victorsvi/SonicMatrix/cover.png

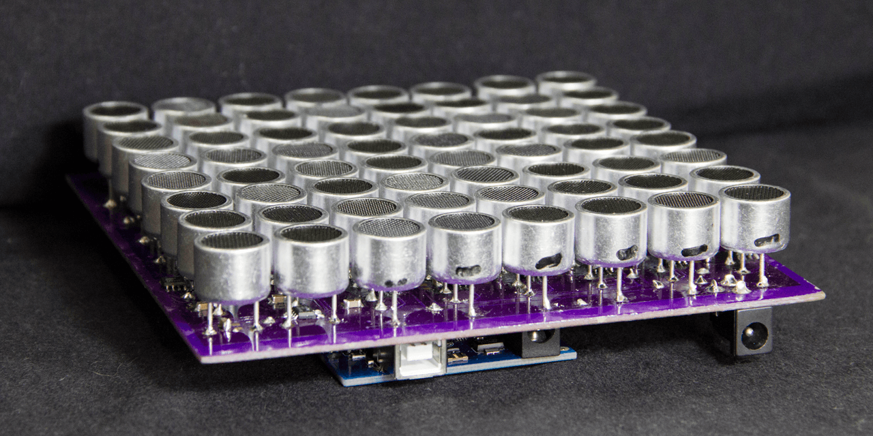
cover.png
