victorsvi/SonicMatrix/hw/doc/Requirements.md

# HARDWARE REQUIREMENTS

- Custom board with 64 transducers controlled by 64 power mosfets in independent channels.
- Must have pin headers aligned to the arduino mega headers.
- Input 12-18VDC.
- Simple series diode reverse polarity protection.
- Have a voltage regulator with 9v output to power the arduino via Vin. There must be a jumper to connect ou disconnect the power to the arduino.
- The board must accomodate the 64 transducers in a 8 x 8 matrix.
