victorsvi/SonicMatrix/sw/doc/Error Codes.md

# ERROR CODES

### GENERIC

|Code|Description|
|---|---|
|1|Memory allocation error|
|2|Unable to open file |
|3|Null pointer |
|4|Index out of bounds |

### ULTRASONIC

|Code|Description|
|---|---|
|40|The transducer array pointer is null |
|41|Invalid size for the transducer array|
|42|Invalid value for transducer diameter|
|43|Invalid value for phase resolution |
|44|The transducer pointer is null |
