victorsvi/SonicMatrix/hw/doc/Datasheets/TCT40 size.jpg

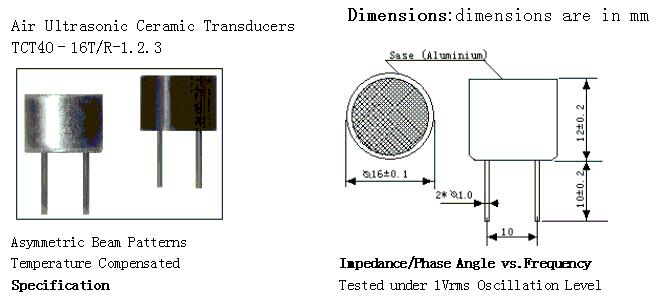
hw/doc/Datasheets/TCT40 size.jpg
