victorsvi/SonicMatrix/hw/doc/Datasheets/TCT40 specs.jpg

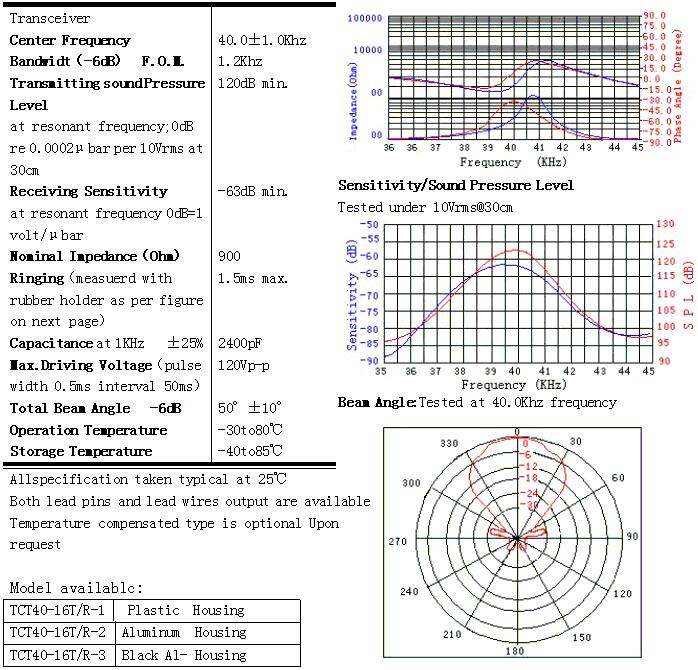
hw/doc/Datasheets/TCT40 specs.jpg
