victorsvi/SonicMatrix/hw/doc/BOM.md

# TRANSDUCER ARRAY BOARD
### Bill of Materials

|Quatity|Part Number|Description|
|---|---|---|
|1|AtMega 2560|Arduino Mega board|
|64|TCT-40-16T|16mm diameter 40kHz ultrasonic transmitter|
|32|TC4427|dual channel power mosfet SOIC|
|1|1n4001|rectifier diode trough hole|
|1|78L09|9V linear regulator TO-92|
|64|-|2.2 uF ceramic capacitor 1206 SMD|
|1|-|tactile switch 5x5 4 pins|
|2|-|100pF ceramic capacitor trough hole|
|1|-|header pin jumper|
|3|-|40x1 male pin header 2.54mm|
|1|-|P4 female DC jack 2,1mm|
