victorsvi/SonicMatrix/hw/board/print/b_mask.pdf

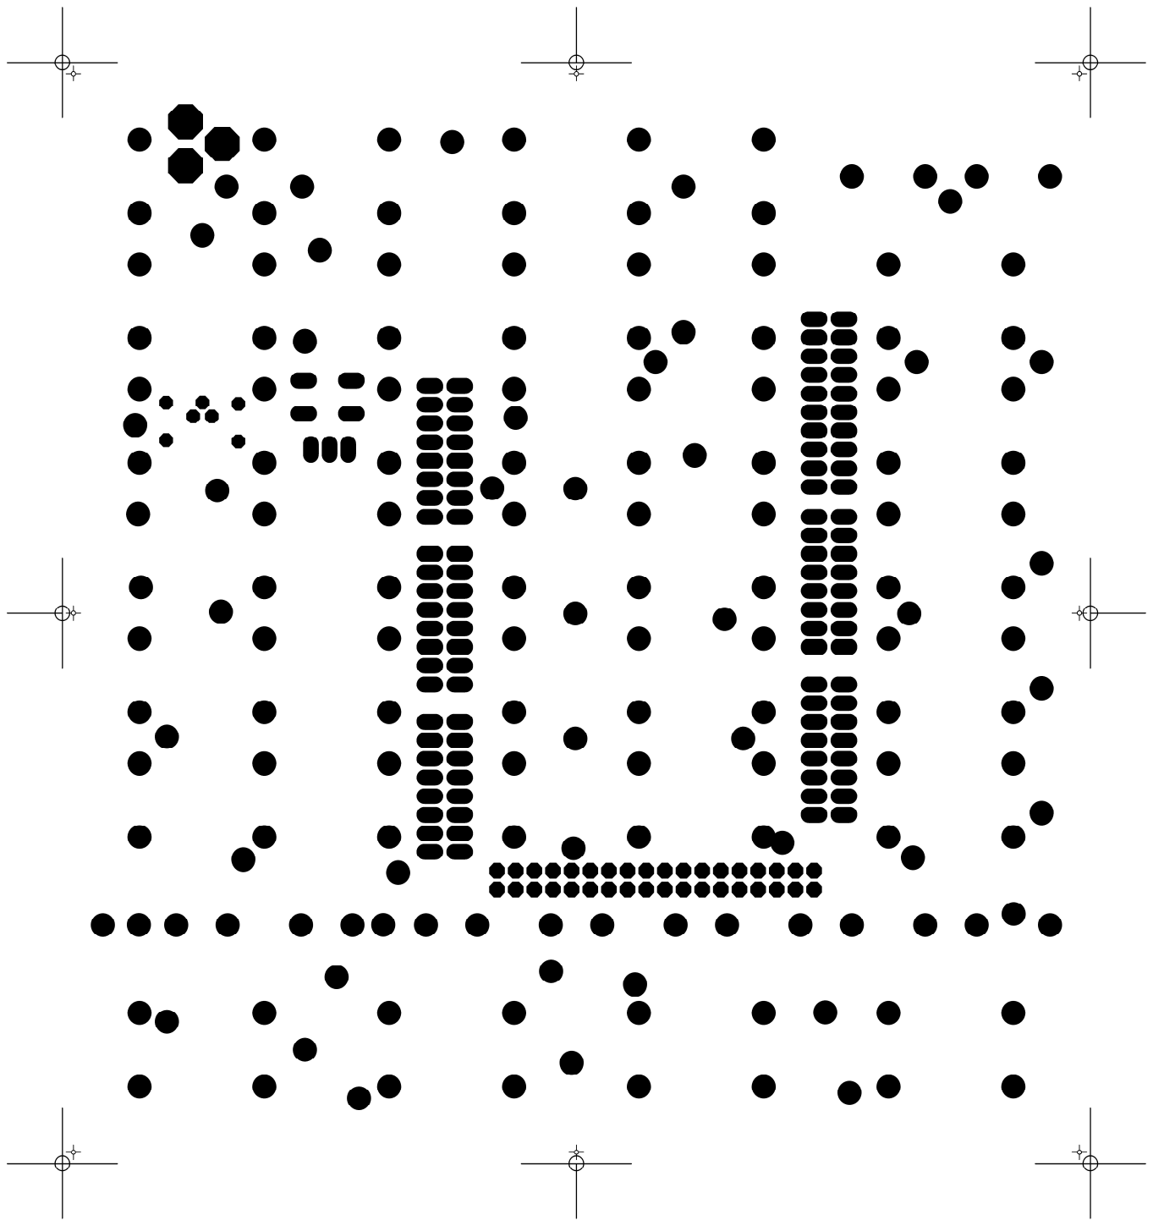
[picture p12: page 1]
