victorsvi/SonicMatrix/hw/board/print/t_mask.pdf

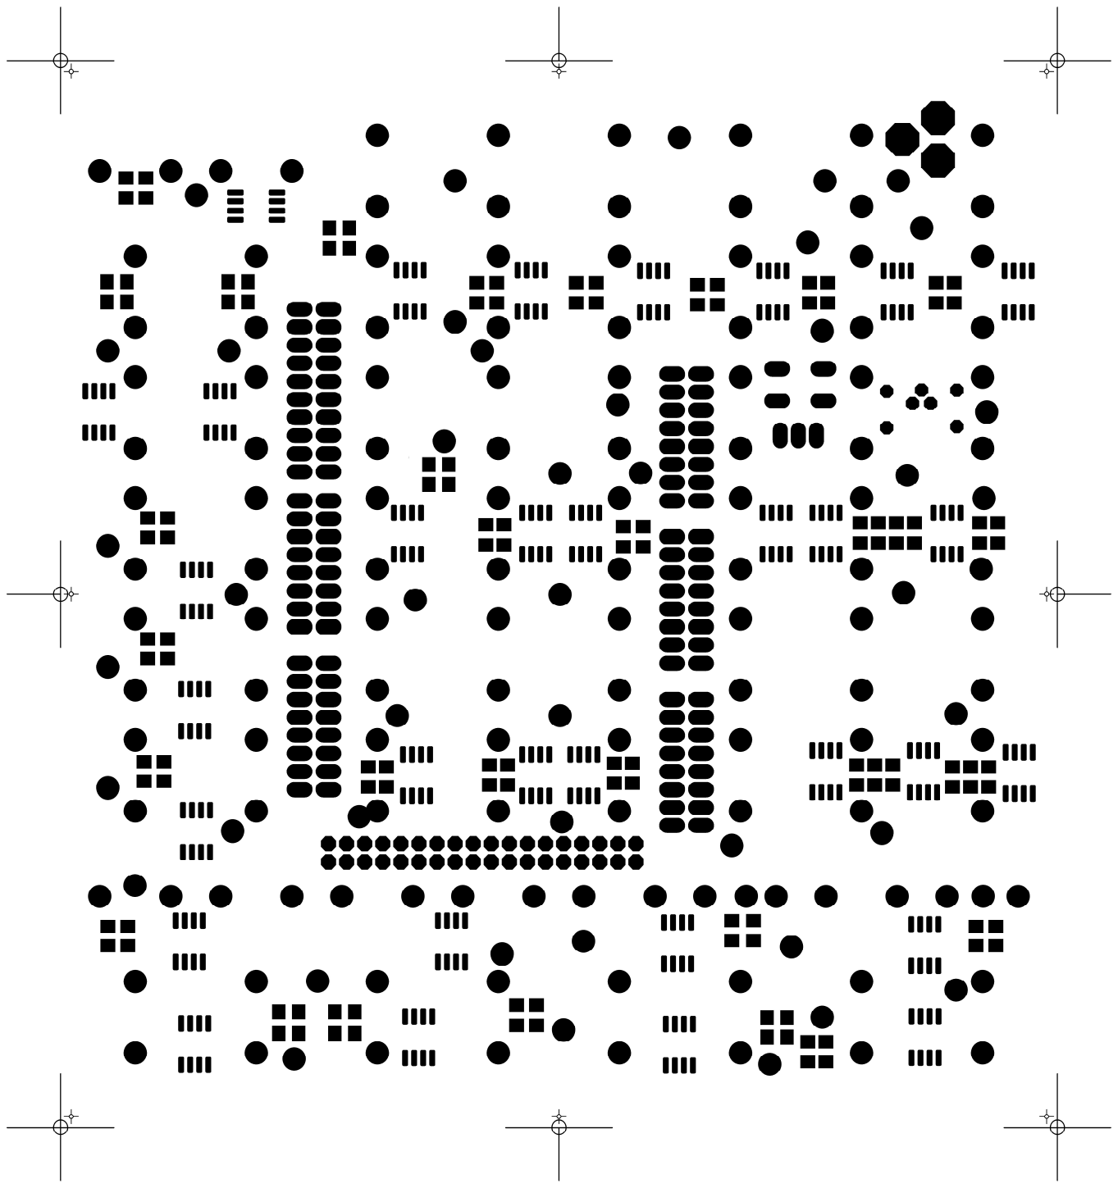
[picture p13: page 1]
