victorsvi/SonicMatrix/hw/board/print/b_etch.png

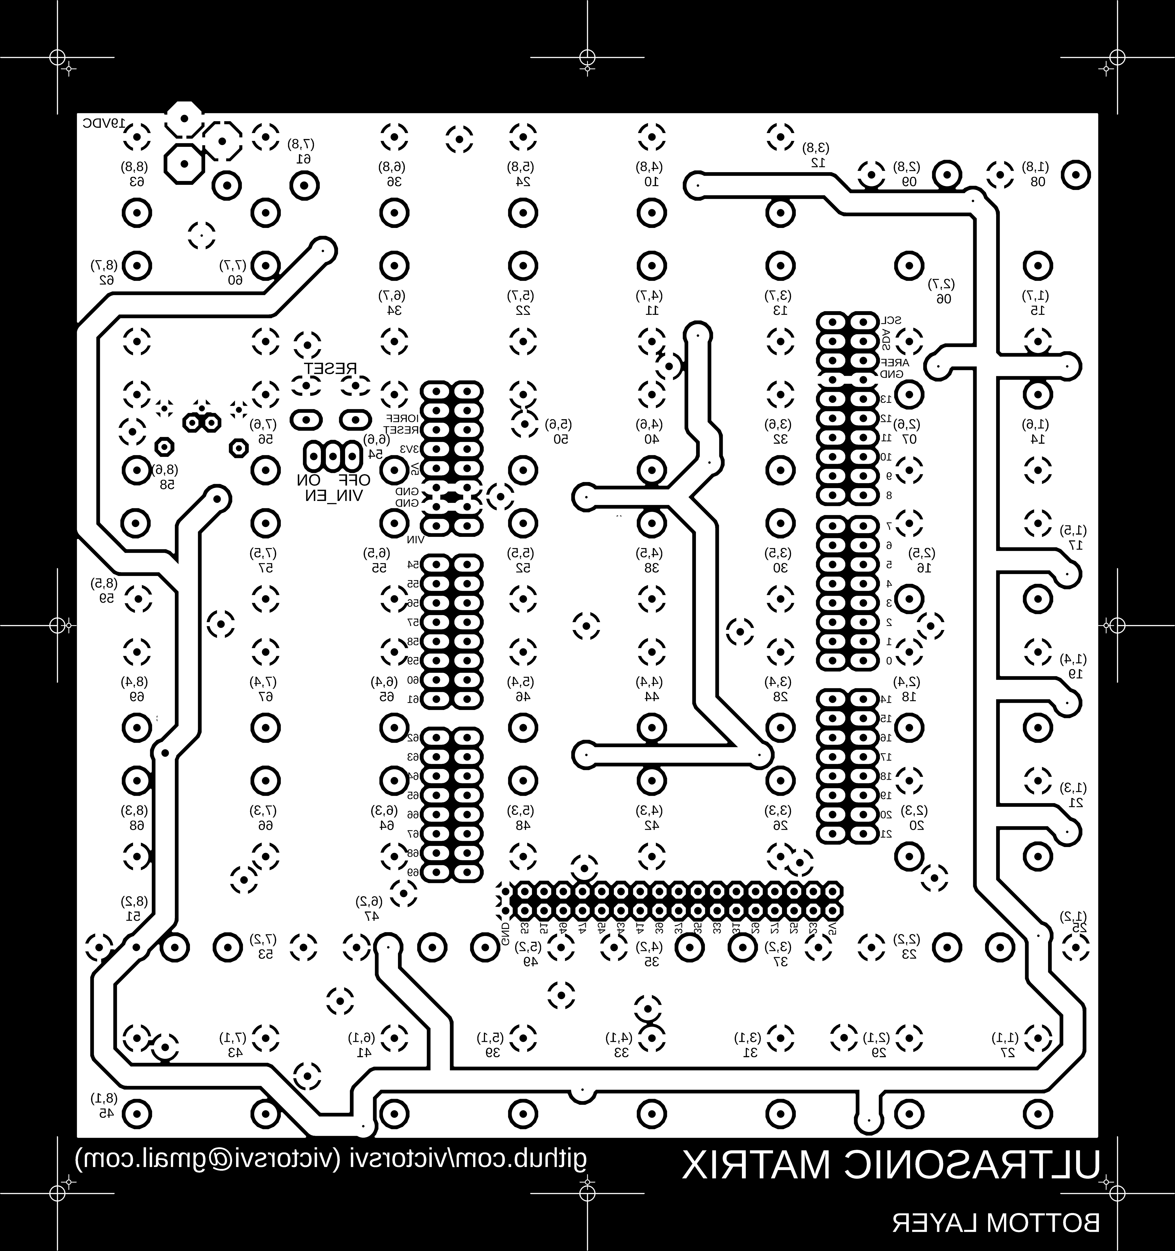
hw/board/print/b_etch.png
