victorsvi/SonicMatrix/hw/board/print/b_mask.png

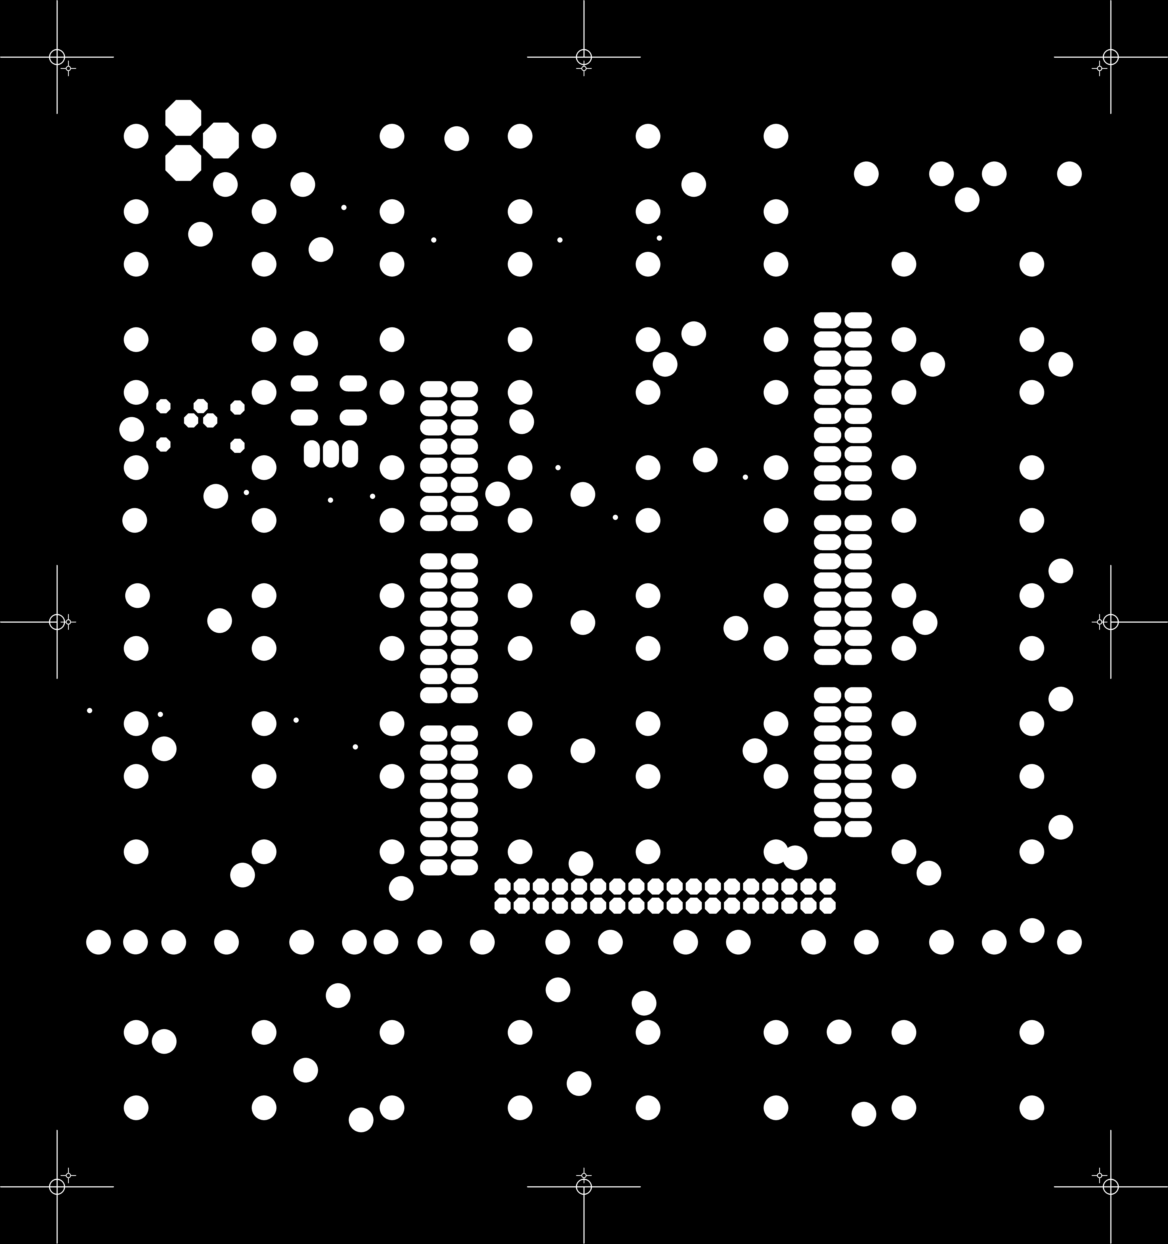
hw/board/print/b_mask.png
