victorsvi/SonicMatrix/hw/board/print/grid2.png

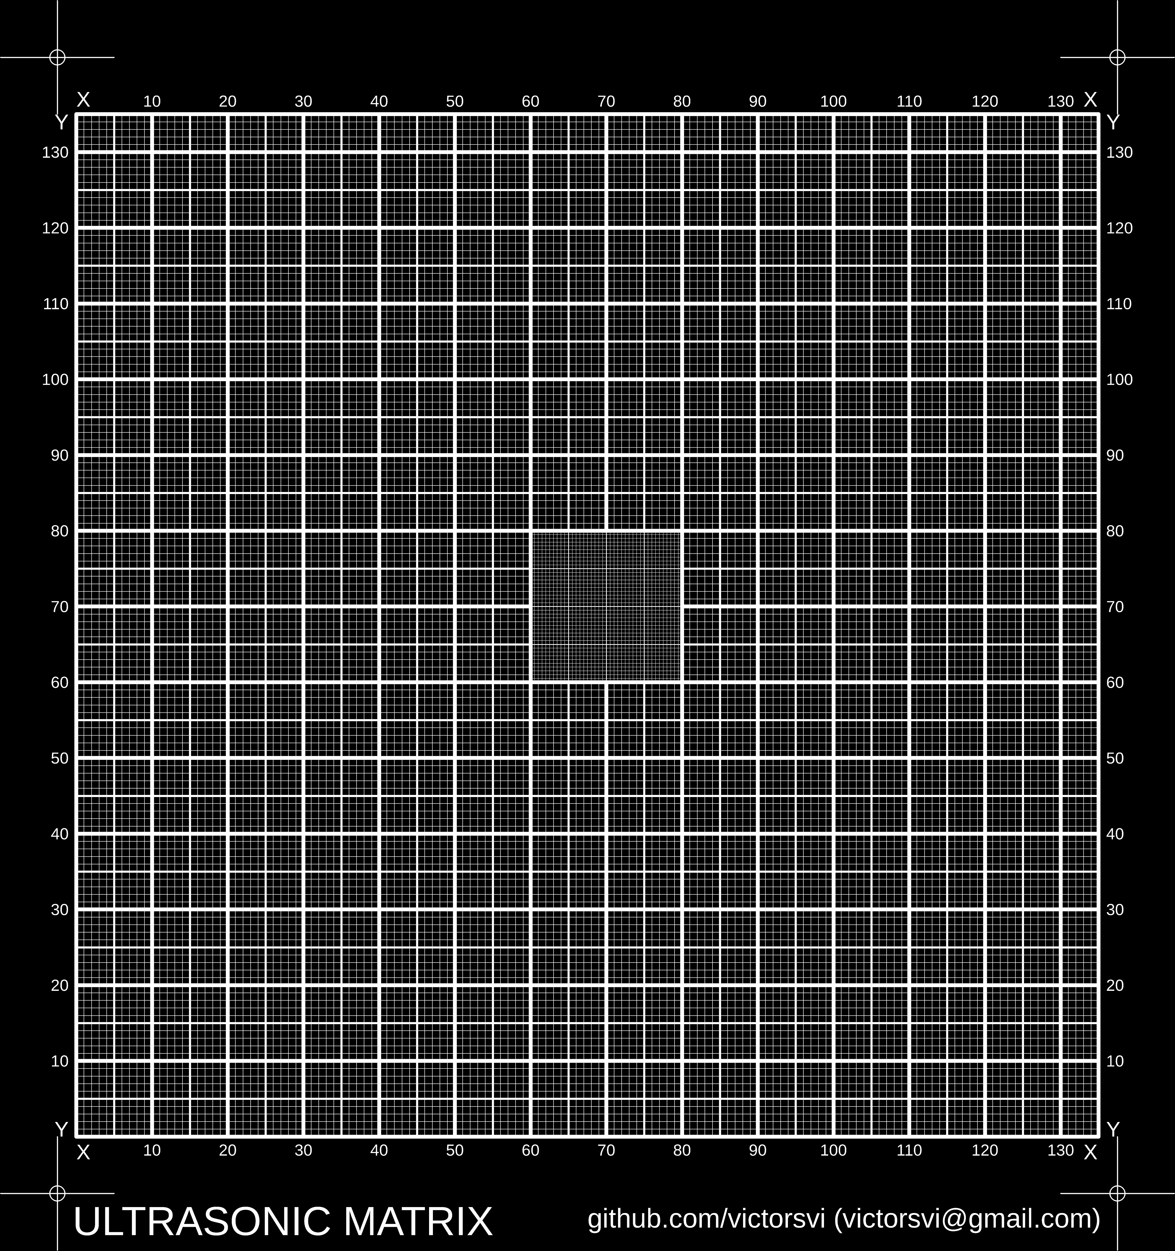
hw/board/print/grid2.png
