victorsvi/SonicMatrix/hw/board/print/place.png

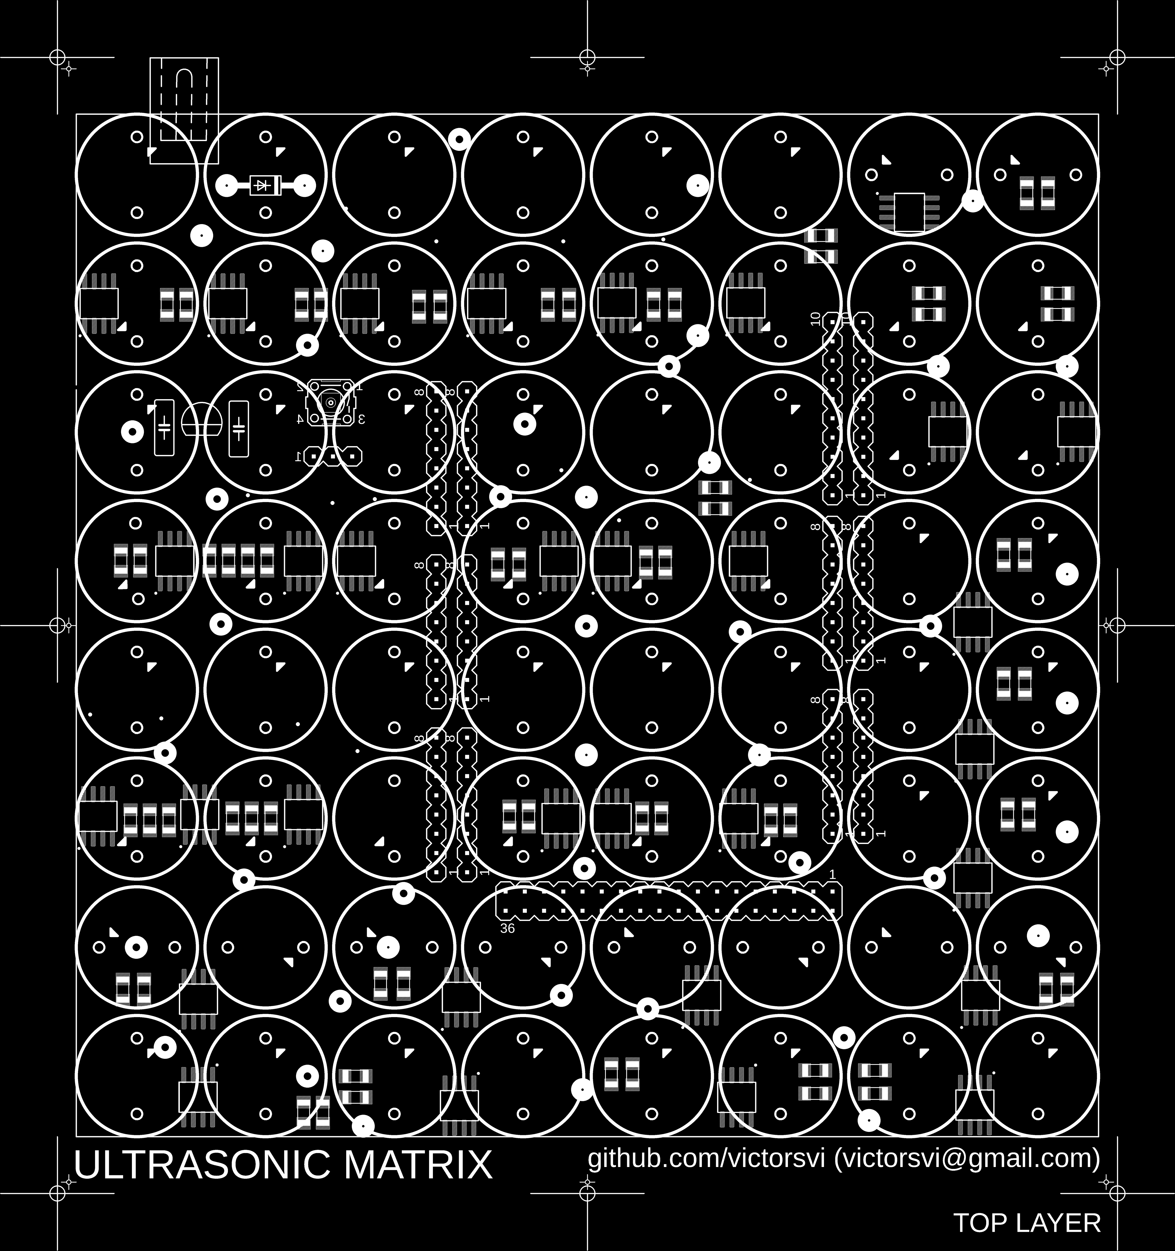
hw/board/print/place.png
