victorsvi/SonicMatrix/hw/board/print/t_etch.png

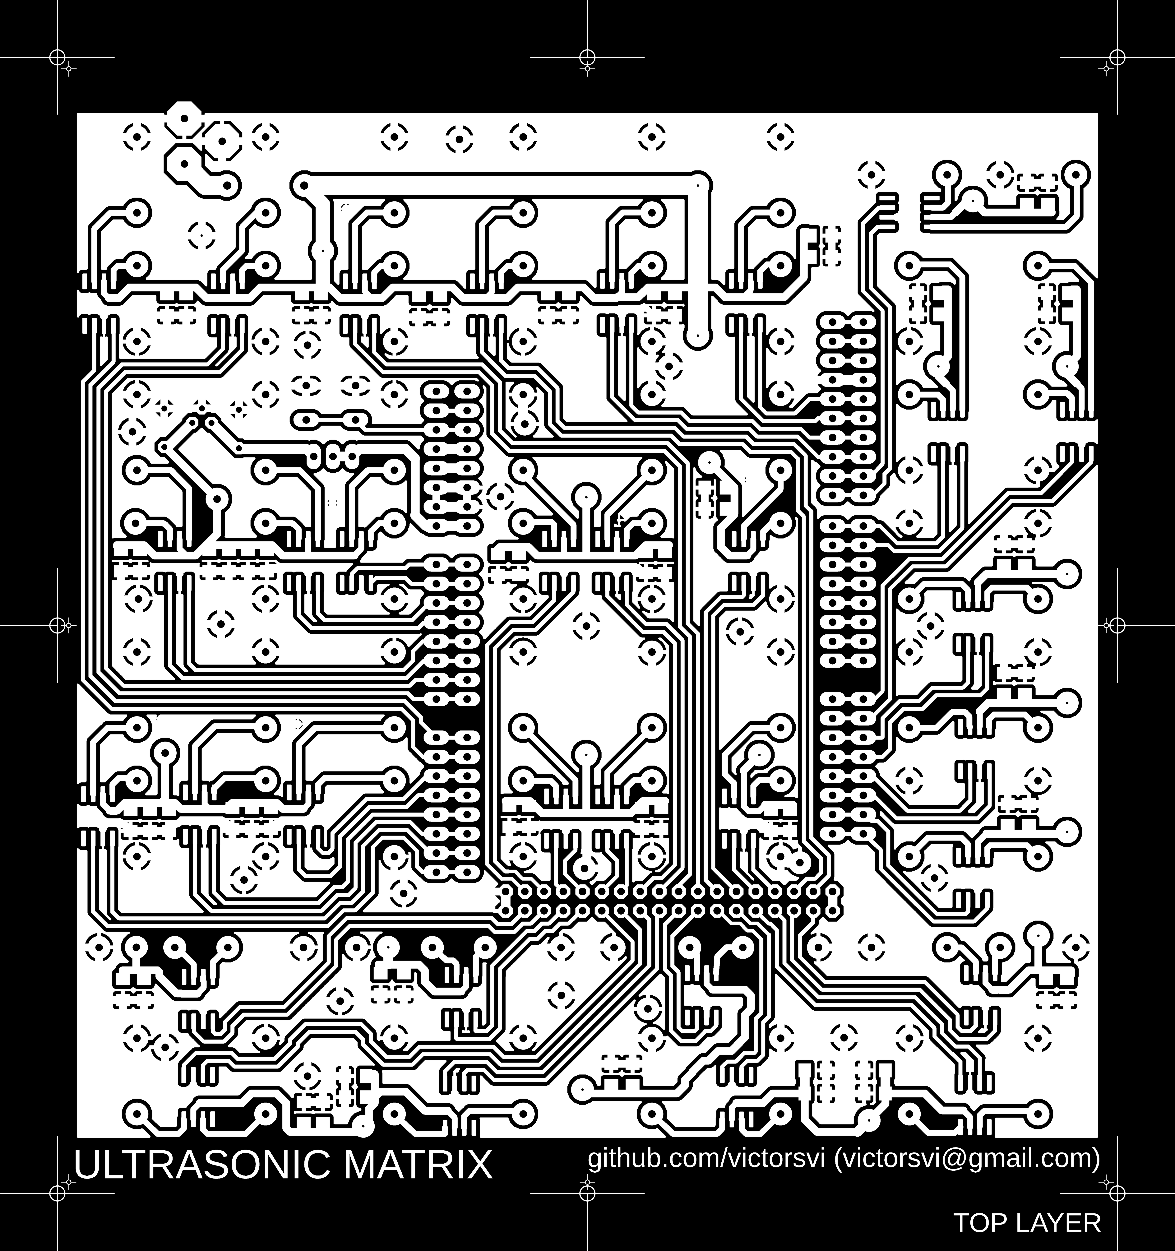
hw/board/print/t_etch.png
