victorsvi/SonicMatrix/hw/board/print/t_mask.png

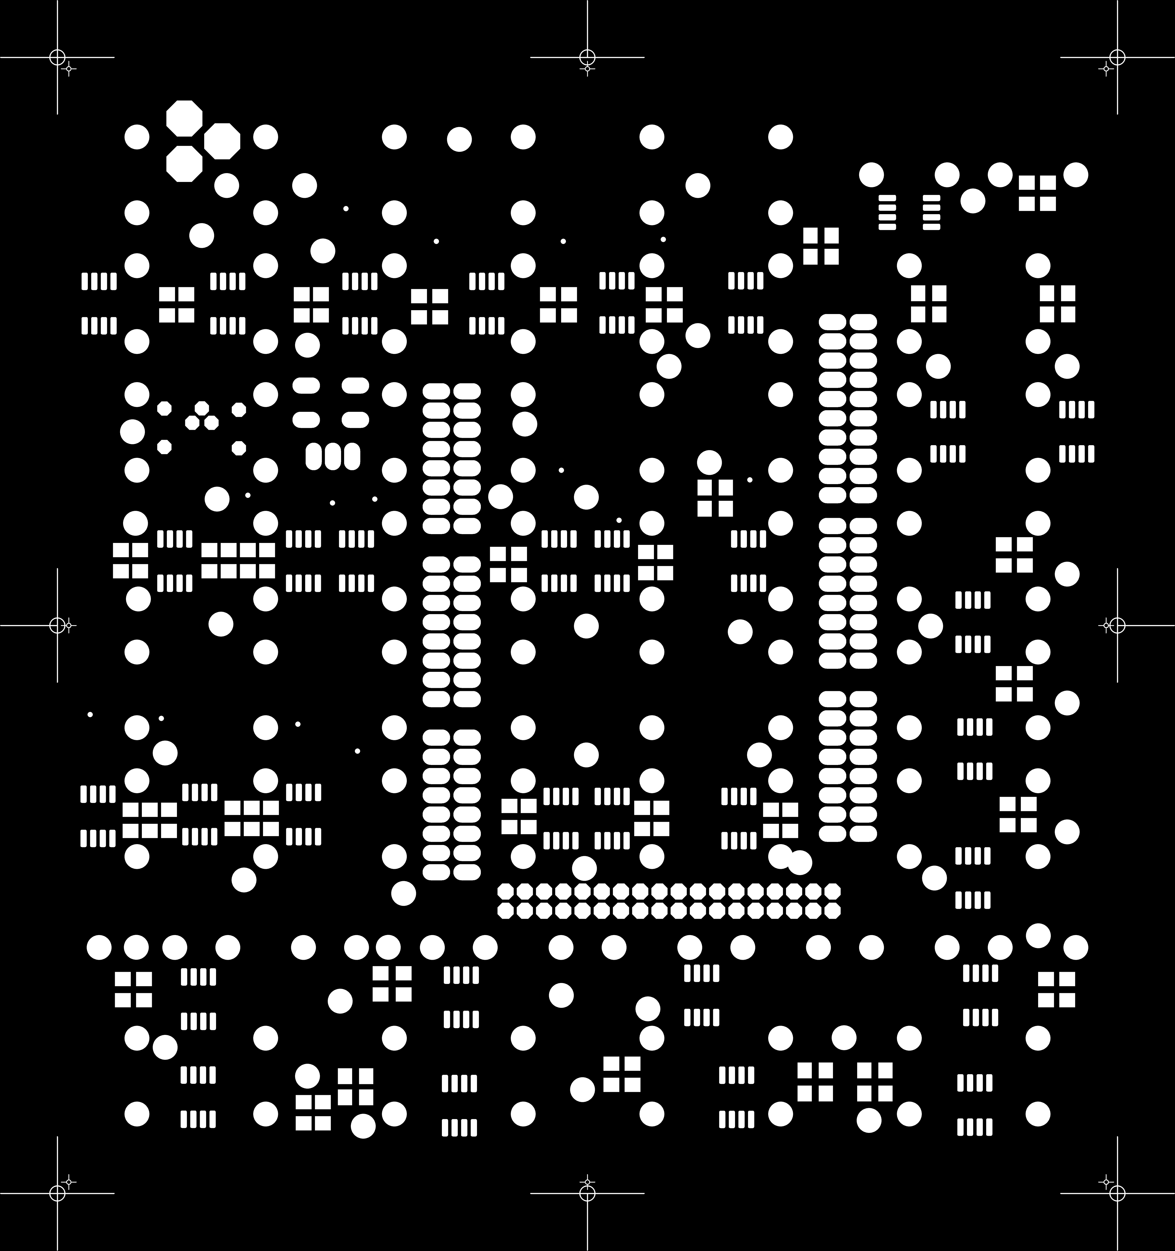
hw/board/print/t_mask.png
