victorsvi/SonicMatrix/sw/doc/Pin Mapping and Calibration.xlsx

BANK | BIT | PIN_NUM | PIN_DESC | USED | ARRAY_X | ARRAY_Y | PH_MEASURE | PH_SUPLEMENT | PH_OFFSET | PH_COMP
PA | 5 | 27 | D27 | TRUE | 1 | 1 | 150 | 210 | 35 | 25 | 27, 25, //x1 y1
PA | 3 | 25 | D25 | TRUE | 1 | 2 | 162 | 198 | 23 | 16 | 25, 16, //x1 y2
PD | 0 | 21 | I2C_SCL | TRUE | 1 | 3 | 139 | 221 | 46 | 33 | 21, 33, //x1 y3
PD | 2 | 19 | USART1_RX | TRUE | 1 | 4 | 121 | 239 | 64 | 45 | 19, 45, //x1 y4
PH | 0 | 17 | USART2_RX | TRUE | 1 | 5 | 150 | 210 | 35 | 25 | 17, 25, //x1 y5
PJ | 1 | 14 | USART3_TX | TRUE | 1 | 6 | 121 | 239 | 64 | 45 | 14, 45, //x1 y6
PJ | 0 | 15 | USART3_RX | TRUE | 1 | 7 | 110 | 250 | 75 | 53 | 15, 53, //x1 y7
PH | 5 | 8 | PWM8 | TRUE | 1 | 8 | 145 | 215 | 40 | 28 | 8, 28, //x1 y8
PA | 7 | 29 | D29 | TRUE | 2 | 1 | 139 | 221 | 46 | 33 | 29, 33, //x2 y1
PA | 1 | 23 | D23 | TRUE | 2 | 2 | 46 | 314 | 139 | 98 | 23, 98, //x2 y2 | invertido? | 133
PD | 1 | 20 | I2C_SDA | TRUE | 2 | 3 | 124 | 236 | 61 | 43 | 20, 43, //x2 y3
PD | 3 | 18 | USART1_TX | TRUE | 2 | 4 | 104 | 256 | 81 | 57 | 18, 57, //x2 y4
PH | 1 | 16 | USART2_TX | TRUE | 2 | 5 | 145 | 215 | 40 | 28 | 16, 28, //x2 y5
PH | 4 | 7 | PWM7 | TRUE | 2 | 6 | 98 | 262 | 87 | 62 | 7, 62, //x2 y6
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
