victorsvi/SonicMatrix/hw/board/UltrasonicMatrix.brd

## EAGLE design hw/board/UltrasonicMatrix.brd (2020-06-22)

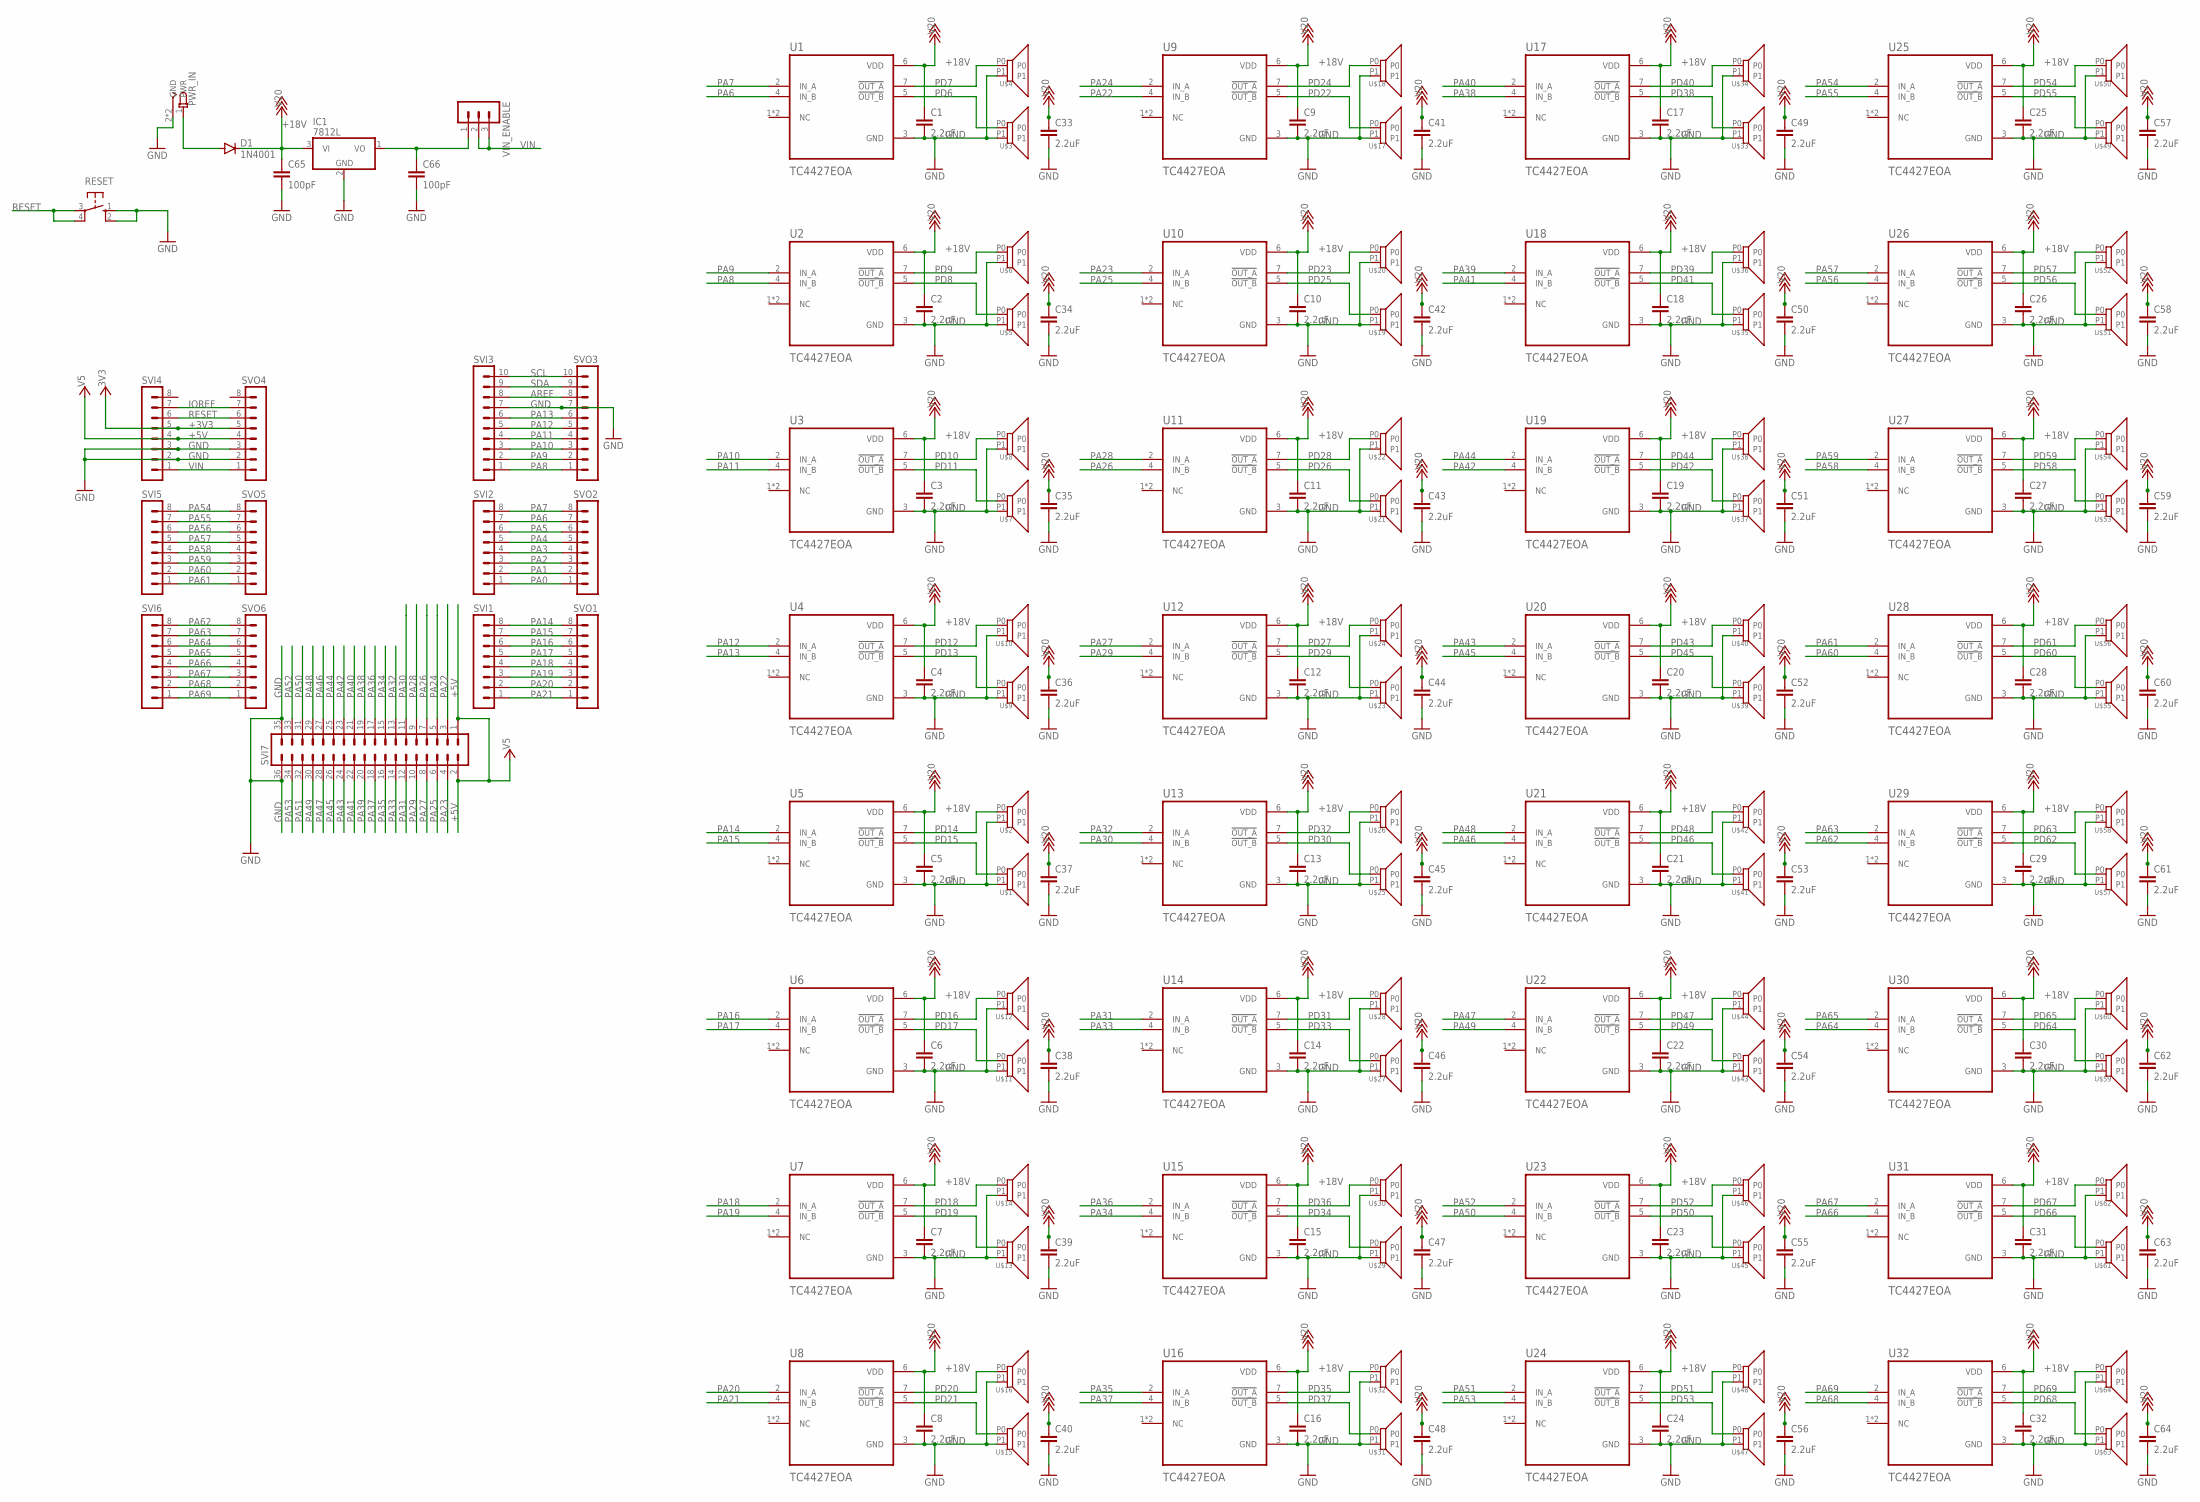
[picture p20: schematic UltrasonicMatrix.sch]

Parts:
C1, C2, C3, C4, C5, C6, C7, C8, C9, C10, C11, C12, C13, C14, C15, C16, C17, C18, C19, C20, C21, C22, C23, C24, C25, C26, C27, C28, C29, C30, C31, C32, C33, C34, C35, C36, C37, C38, C39, C40, C41, C42, C43, C44, C45, C46, C47, C48, C49, C50, C51, C52, C53, C54, C55, C56, C57, C58, C59, C60, C61, C62, C63, C64: 2.2uF; C1206
C65, C66: 100pF; C050-025X075
D1: 1N4001; DO41-10
IC1: 7812L; TO92
PWR_IN: DCJACK
RESET: 10-XX; B3F-10XX
SVI1, SVI2, SVI4, SVI5, SVI6: MA08-1
SVI3: MA10-1
SVI7: MA18-2
SVO1, SVO2, SVO4, SVO5, SVO6: MA08-1
SVO3: MA10-1
U1, U2, U3, U4, U5, U6, U7, U8, U9, U10, U11, U12, U13, U14, U15, U16, U17, U18, U19, U20, U21, U22, U23, U24, U25, U26, U27, U28, U29, U30, U31, U32: TC4427EOA; SOIC127P599X175-8N
U$1, U$2, U$3, U$4, U$5, U$6, U$7, U$8, U$9, U$10, U$11, U$12, U$13, U$14, U$15, U$16, U$17, U$18, U$19, U$20, U$21, U$22, U$23, U$24, U$25, U$26, U$27, U$28, U$29, U$30, U$31, U$32, U$33, U$34, U$35, U$36, U$37, U$38, U$39, U$40, U$41, U$42, U$43, U$44, U$45, U$46, U$47, U$48, U$49, U$50, U$51, U$52, U$53, U$54, U$55, U$56, U$57, U$58, U$59, U$60, U$61, U$62, U$63, U$64: TCT40-16
VIN_ENABLE: MA03-1

Connections:
+3V3: SVI4.5, SVO4.5
+5V: SVI4.4, SVI7.1, SVI7.2, SVO4.4
+18V: C1.1, C2.1, C3.1, C4.1, C5.1, C6.1, C7.1, C8.1, C9.1, C10.1, C11.1, C12.1, C13.1, C14.1, C15.1, C16.1, C17.1, C18.1, C19.1, C20.1, C21.1, C22.1, C23.1, C24.1, C25.1, C26.1, C27.1, C28.1, C29.1, C30.1, C31.1, C32.1, C33.1, C34.1, C35.1, C36.1, C37.1, C38.1, C39.1, C40.1, C41.1, C42.1, C43.1, C44.1, C45.1, C46.1, C47.1, C48.1, C49.1, C50.1, C51.1, C52.1, C53.1, C54.1, C55.1, C56.1, C57.1, C58.1, C59.1, C60.1, C61.1, C62.1, C63.1, C64.1, C65.1, D1.C, IC1.3 (VI), U1.6 (VDD), U2.6 (VDD), U3.6 (VDD), U4.6 (VDD), U5.6 (VDD), U6.6 (VDD), U7.6 (VDD), U8.6 (VDD), U9.6 (VDD), U10.6 (VDD), U11.6 (VDD), U12.6 (VDD), U13.6 (VDD), U14.6 (VDD), U15.6 (VDD), U16.6 (VDD), U17.6 (VDD), U18.6 (VDD), U19.6 (VDD), U20.6 (VDD), U21.6 (VDD), U22.6 (VDD), U23.6 (VDD), U24.6 (VDD), U25.6 (VDD), U26.6 (VDD), U27.6 (VDD), U28.6 (VDD), U29.6 (VDD), U30.6 (VDD), U31.6 (VDD), U32.6 (VDD)
AREF: SVI3.8, SVO3.8
GND: C1.2, C2.2, C3.2, C4.2, C5.2, C6.2, C7.2, C8.2, C9.2, C10.2, C11.2, C12.2, C13.2, C14.2, C15.2, C16.2, C17.2, C18.2, C19.2, C20.2, C21.2, C22.2, C23.2, C24.2, C25.2, C26.2, C27.2, C28.2, C29.2, C30.2, C31.2, C32.2, C33.2, C34.2, C35.2, C36.2, C37.2, C38.2, C39.2, C40.2, C41.2, C42.2, C43.2, C44.2, C45.2, C46.2, C47.2, C48.2, C49.2, C50.2, C51.2, C52.2, C53.2, C54.2, C55.2, C56.2, C57.2, C58.2, C59.2, C60.2, C61.2, C62.2, C63.2, C64.2, C65.2, C66.2, IC1.2 (GND), PWR_IN.2 (GND), PWR_IN.3 (GND), RESET.1 (S), RESET.2 (S1), SVI3.7, SVI4.2, SVI4.3, SVI7.35, SVI7.36, SVO3.7, SVO4.2, SVO4.3, U1.3 (GND), U2.3 (GND), U3.3 (GND), U4.3 (GND), U5.3 (GND), U6.3 (GND), U7.3 (GND), U8.3 (GND), U9.3 (GND), U10.3 (GND), U11.3 (GND), U12.3 (GND), U13.3 (GND), U14.3 (GND), U15.3 (GND), U16.3 (GND), U17.3 (GND), U18.3 (GND), U19.3 (GND), U20.3 (GND), U21.3 (GND), U22.3 (GND), U23.3 (GND), U24.3 (GND), U25.3 (GND), U26.3 (GND), U27.3 (GND), U28.3 (GND), U29.3 (GND), U30.3 (GND), U31.3 (GND), U32.3 (GND), U$1.P1, U$2.P1, U$3.P1, U$4.P1, U$5.P1, U$6.P1, U$7.P1, U$8.P1, U$9.P1, U$10.P1, U$11.P1, U$12.P1, U$13.P1, U$14.P1, U$15.P1, U$16.P1, U$17.P1, U$18.P1, U$19.P1, U$20.P1, U$21.P1, U$22.P1, U$23.P1, U$24.P1, U$25.P1, U$26.P1, U$27.P1, U$28.P1, U$29.P1, U$30.P1, U$31.P1, U$32.P1, U$33.P1, U$34.P1, U$35.P1, U$36.P1, U$37.P1, U$38.P1, U$39.P1, U$40.P1, U$41.P1, U$42.P1, U$43.P1, U$44.P1, U$45.P1, U$46.P1, U$47.P1, U$48.P1, U$49.P1, U$50.P1, U$51.P1, U$52.P1, U$53.P1, U$54.P1, U$55.P1, U$56.P1, U$57.P1, U$58.P1, U$59.P1, U$60.P1, U$61.P1, U$62.P1, U$63.P1, U$64.P1
IOREF: SVI4.7, SVO4.7
unnamed: D1.A, PWR_IN.1 (PWR)
unnamed: C66.1, IC1.1 (VO), VIN_ENABLE.1
PA0: SVI2.1, SVO2.1
PA1: SVI2.2, SVO2.2
PA2: SVI2.3, SVO2.3
PA3: SVI2.4, SVO2.4
PA4: SVI2.5, SVO2.5
PA5: SVI2.6, SVO2.6
PA6: SVI2.7, SVO2.7, U1.4 (IN_B)
PA7: SVI2.8, SVO2.8, U1.2 (IN_A)
PA8: SVI3.1, SVO3.1, U2.4 (IN_B)
PA9: SVI3.2, SVO3.2, U2.2 (IN_A)
PA10: SVI3.3, SVO3.3, U3.2 (IN_A)
PA11: SVI3.4, SVO3.4, U3.4 (IN_B)
PA12: SVI3.5, SVO3.5, U4.2 (IN_A)
PA13: SVI3.6, SVO3.6, U4.4 (IN_B)
PA14: SVI1.8, SVO1.8, U5.2 (IN_A)
PA15: SVI1.7, SVO1.7, U5.4 (IN_B)
PA16: SVI1.6, SVO1.6, U6.2 (IN_A)
PA17: SVI1.5, SVO1.5, U6.4 (IN_B)
PA18: SVI1.4, SVO1.4, U7.2 (IN_A)
PA19: SVI1.3, SVO1.3, U7.4 (IN_B)
PA20: SVI1.2, SVO1.2, U8.2 (IN_A)
PA21: SVI1.1, SVO1.1, U8.4 (IN_B)
PA22: SVI7.3, U9.4 (IN_B)
PA23: SVI7.4, U10.2 (IN_A)
PA24: SVI7.5, U9.2 (IN_A)
PA25: SVI7.6, U10.4 (IN_B)
PA26: SVI7.7, U11.4 (IN_B)
PA27: SVI7.8, U12.2 (IN_A)
PA28: SVI7.9, U11.2 (IN_A)
PA29: SVI7.10, U12.4 (IN_B)
PA30: SVI7.11, U13.4 (IN_B)
PA31: SVI7.12, U14.2 (IN_A)
PA32: SVI7.13, U13.2 (IN_A)
PA33: SVI7.14, U14.4 (IN_B)
PA34: SVI7.15, U15.4 (IN_B)
PA35: SVI7.16, U16.2 (IN_A)
PA36: SVI7.17, U15.2 (IN_A)
PA37: SVI7.18, U16.4 (IN_B)
PA38: SVI7.19, U17.4 (IN_B)
PA39: SVI7.20, U18.2 (IN_A)
PA40: SVI7.21, U17.2 (IN_A)
PA41: SVI7.22, U18.4 (IN_B)
PA42: SVI7.23, U19.4 (IN_B)
PA43: SVI7.24, U20.2 (IN_A)
PA44: SVI7.25, U19.2 (IN_A)
PA45: SVI7.26, U20.4 (IN_B)
PA46: SVI7.27, U21.4 (IN_B)
PA47: SVI7.28, U22.2 (IN_A)
PA48: SVI7.29, U21.2 (IN_A)
PA49: SVI7.30, U22.4 (IN_B)
PA50: SVI7.31, U23.4 (IN_B)
PA51: SVI7.32, U24.2 (IN_A)
PA52: SVI7.33, U23.2 (IN_A)
PA53: SVI7.34, U24.4 (IN_B)
PA54: SVI5.8, SVO5.8, U25.2 (IN_A)
PA55: SVI5.7, SVO5.7, U25.4 (IN_B)
PA56: SVI5.6, SVO5.6, U26.4 (IN_B)
PA57: SVI5.5, SVO5.5, U26.2 (IN_A)
PA58: SVI5.4, SVO5.4, U27.4 (IN_B)
PA59: SVI5.3, SVO5.3, U27.2 (IN_A)
PA60: SVI5.2, SVO5.2, U28.4 (IN_B)
PA61: SVI5.1, SVO5.1, U28.2 (IN_A)
PA62: SVI6.8, SVO6.8, U29.4 (IN_B)
PA63: SVI6.7, SVO6.7, U29.2 (IN_A)
PA64: SVI6.6, SVO6.6, U30.4 (IN_B)
PA65: SVI6.5, SVO6.5, U30.2 (IN_A)
PA66: SVI6.4, SVO6.4, U31.4 (IN_B)
PA67: SVI6.3, SVO6.3, U31.2 (IN_A)
PA68: SVI6.2, SVO6.2, U32.4 (IN_B)
PA69: SVI6.1, SVO6.1, U32.2 (IN_A)
PD6: U1.5 (!OUT_B), U$3.P0
PD7: U1.7 (!OUT_A), U$4.P0
PD8: U2.5 (!OUT_B), U$5.P0
PD9: U2.7 (!OUT_A), U$6.P0
PD10: U3.7 (!OUT_A), U$8.P0
PD11: U3.5 (!OUT_B), U$7.P0
PD12: U4.7 (!OUT_A), U$10.P0
PD13: U4.5 (!OUT_B), U$9.P0
PD14: U5.7 (!OUT_A), U$2.P0
PD15: U5.5 (!OUT_B), U$1.P0
PD16: U6.7 (!OUT_A), U$12.P0
PD17: U6.5 (!OUT_B), U$11.P0
PD18: U7.7 (!OUT_A), U$14.P0
PD19: U7.5 (!OUT_B), U$13.P0
PD20: U8.7 (!OUT_A), U$16.P0
PD21: U8.5 (!OUT_B), U$15.P0
PD22: U9.5 (!OUT_B), U$17.P0
PD23: U10.7 (!OUT_A), U$20.P0
PD24: U9.7 (!OUT_A), U$18.P0
PD25: U10.5 (!OUT_B), U$19.P0
PD26: U11.5 (!OUT_B), U$21.P0
PD27: U12.7 (!OUT_A), U$24.P0
PD28: U11.7 (!OUT_A), U$22.P0
PD29: U12.5 (!OUT_B), U$23.P0
PD30: U13.5 (!OUT_B), U$25.P0
PD31: U14.7 (!OUT_A), U$28.P0
PD32: U13.7 (!OUT_A), U$26.P0
PD33: U14.5 (!OUT_B), U$27.P0
PD34: U15.5 (!OUT_B), U$29.P0
PD35: U16.7 (!OUT_A), U$32.P0
PD36: U15.7 (!OUT_A), U$30.P0
PD37: U16.5 (!OUT_B), U$31.P0
PD38: U17.5 (!OUT_B), U$33.P0
PD39: U18.7 (!OUT_A), U$36.P0
PD40: U17.7 (!OUT_A), U$34.P0
PD41: U18.5 (!OUT_B), U$35.P0
PD42: U19.5 (!OUT_B), U$37.P0
PD43: U20.7 (!OUT_A), U$40.P0
PD44: U19.7 (!OUT_A), U$38.P0
PD45: U20.5 (!OUT_B), U$39.P0
PD46: U21.5 (!OUT_B), U$41.P0
PD47: U22.7 (!OUT_A), U$44.P0
PD48: U21.7 (!OUT_A), U$42.P0
PD49: U22.5 (!OUT_B), U$43.P0
PD50: U23.5 (!OUT_B), U$45.P0
PD51: U24.7 (!OUT_A), U$48.P0
PD52: U23.7 (!OUT_A), U$46.P0
PD53: U24.5 (!OUT_B), U$47.P0
PD54: U25.7 (!OUT_A), U$50.P0
PD55: U25.5 (!OUT_B), U$49.P0
PD56: U26.5 (!OUT_B), U$51.P0
PD57: U26.7 (!OUT_A), U$52.P0
PD58: U27.5 (!OUT_B), U$53.P0
PD59: U27.7 (!OUT_A), U$54.P0
PD60: U28.5 (!OUT_B), U$55.P0
PD61: U28.7 (!OUT_A), U$56.P0
PD62: U29.5 (!OUT_B), U$57.P0
PD63: U29.7 (!OUT_A), U$58.P0
PD64: U30.5 (!OUT_B), U$59.P0
PD65: U30.7 (!OUT_A), U$60.P0
PD66: U31.5 (!OUT_B), U$61.P0
PD67: U31.7 (!OUT_A), U$62.P0
PD68: U32.5 (!OUT_B), U$63.P0
PD69: U32.7 (!OUT_A), U$64.P0
RESET: RESET.3, RESET.4 (P1), SVI4.6, SVO4.6
SCL: SVI3.10, SVO3.10
SDA: SVI3.9, SVO3.9
VIN: SVI4.1, SVO4.1, VIN_ENABLE.2, VIN_ENABLE.3

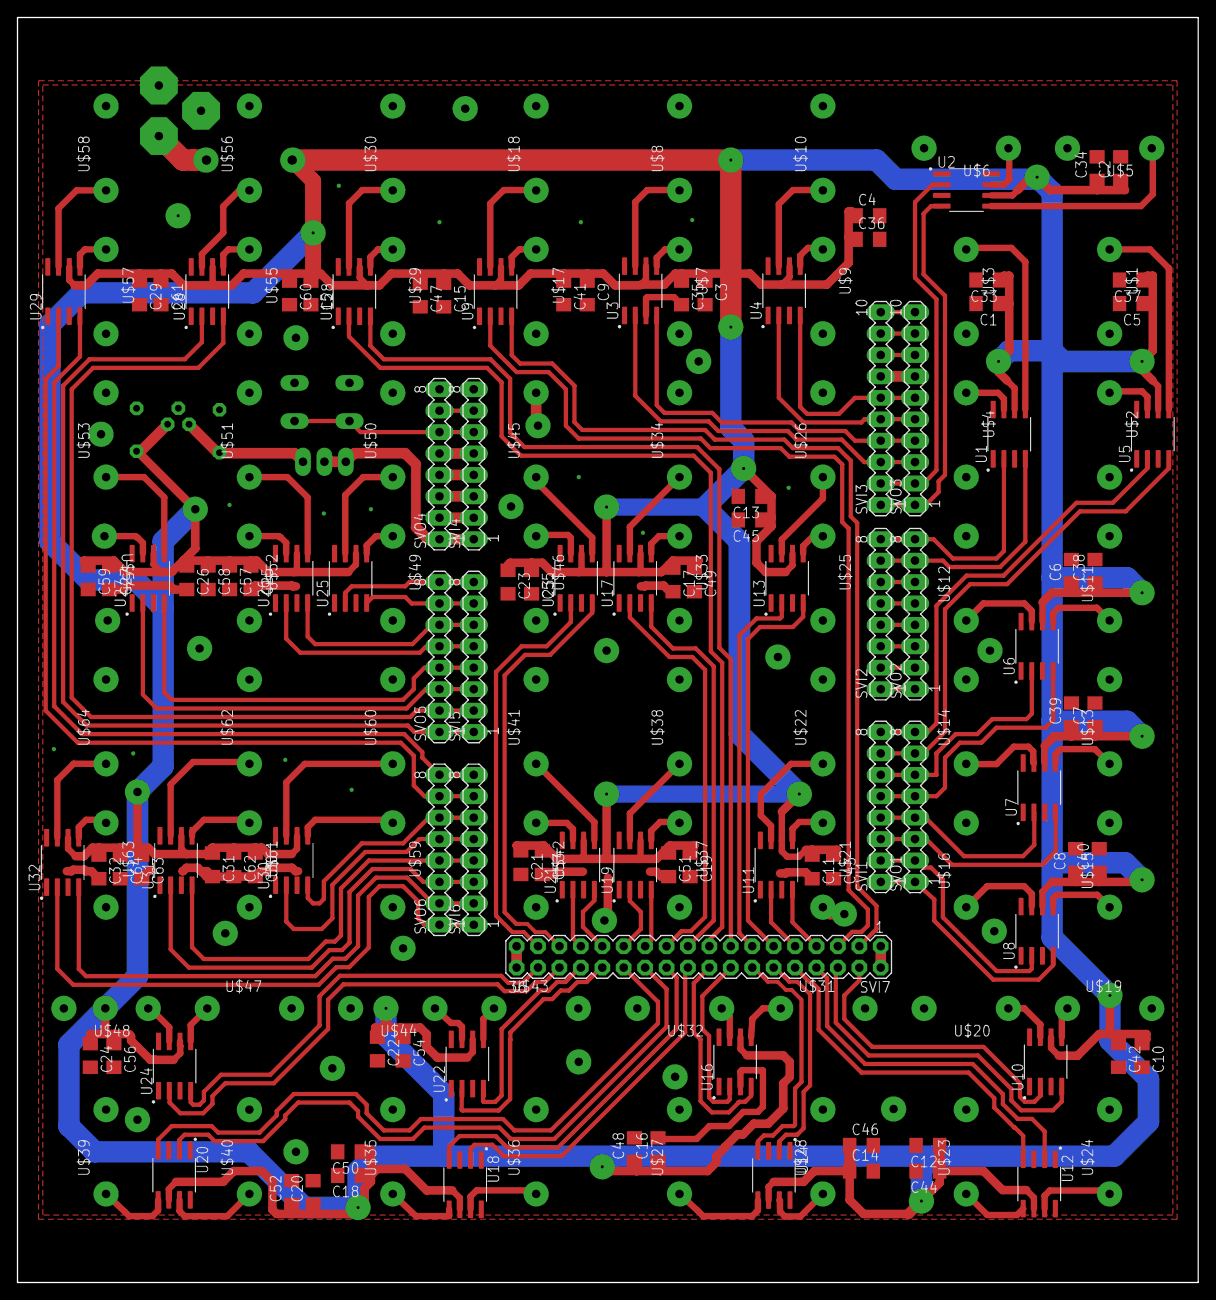
[picture p21: board UltrasonicMatrix.brd from above]

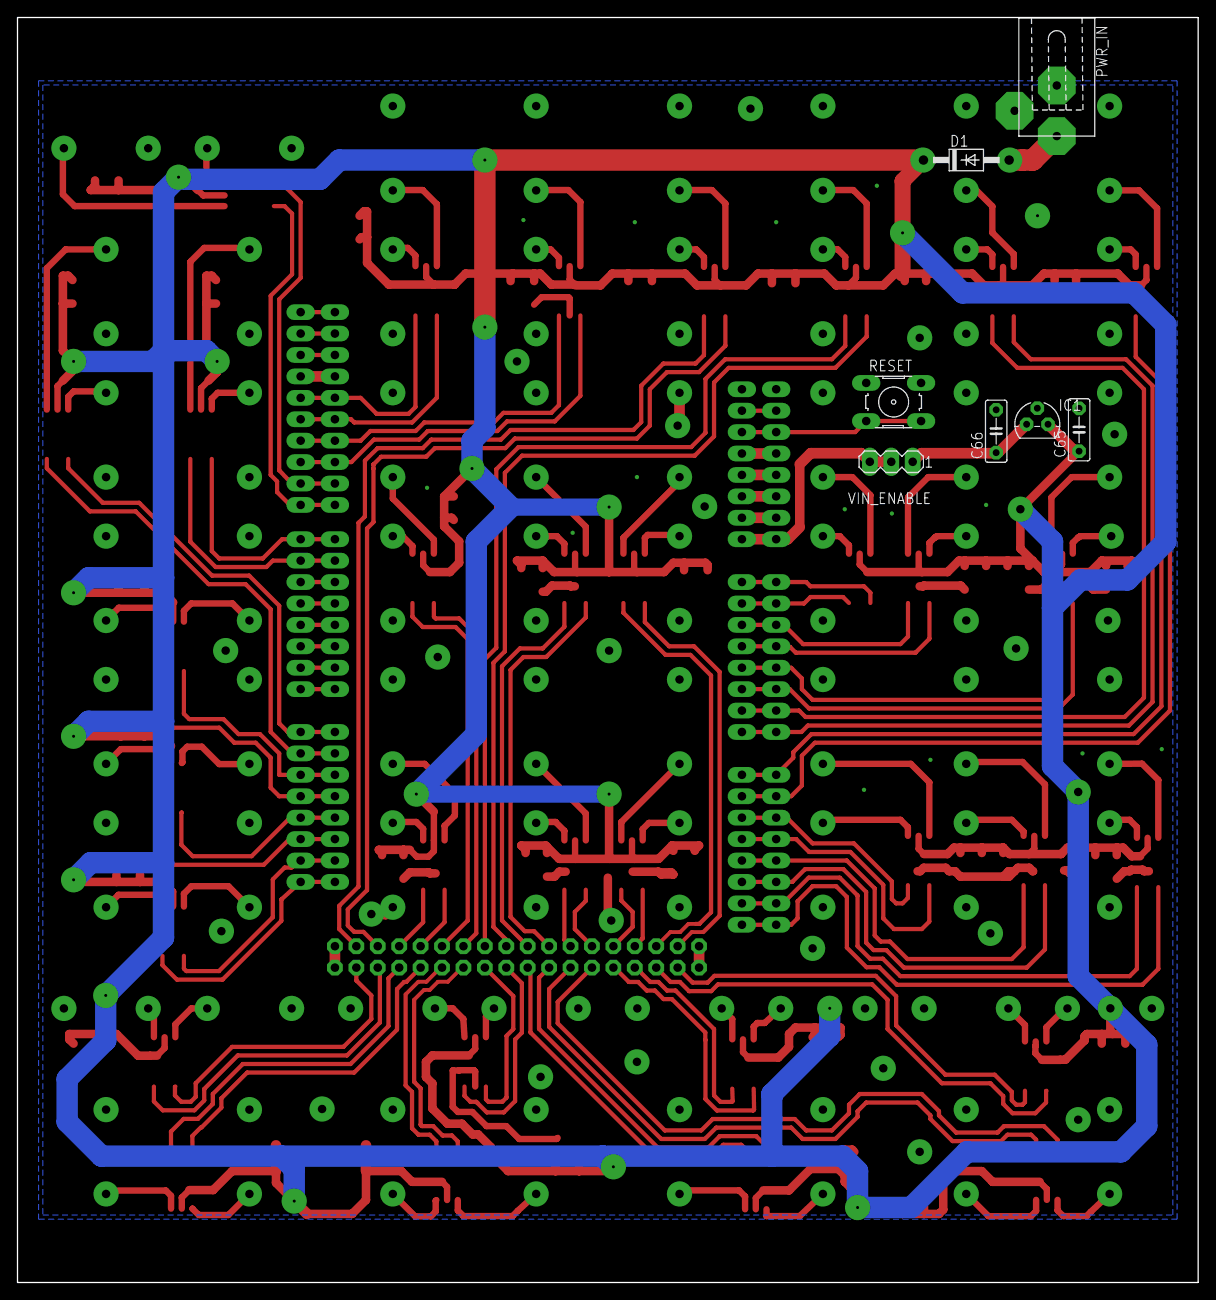
[picture p22: board UltrasonicMatrix.brd from below]

Board: 2 copper layers, 140.0 x 150.0 mm, 180 parts (7 on the bottom side), 146 nets.
