victorsvi/SonicMatrix/sw/src/Timer3.h

#ifndef TIMER5_H
#define TIMER5_H

#ifdef __cplusplus
	extern "C" {
#endif

#include <stdint.h>

void setTimer3 (uint32_t interval);
void enableTimer3 ();
void disableTimer3 ();

#ifdef __cplusplus
	}
#endif

#endif
