victorsvi/SonicMatrix/(commit log)

2020-03-02 Frist Comit
    [Mega Port Registers.xlsx]
2020-03-03 Ultrasonic header
    the ultrassonic array data structures and interfaces were defined
2020-03-14 Phase calculation and Dump funcion
    [Ultrasonic Dump JSON.txt]
2020-03-15 Ultrasonic test routine
    and bug fixes of Ultrasonic class
    [Debug.h, Ultrasonic.c, Ultrasonic.h]
2020-03-16 Final test of Ultrasonic
    Bug fixes in phase and pattern calculation (rounding problems of integer algebra).
    Upgraded algorithm to generate the pattern.
    Updated test program.
    New csv export.
    [UltrasonicDump.csv, UltrasonicDump.xlsx]
2020-03-17 New stripped down version
    Also a fix on Ultrasonic:transd_calcflat which phase compensation were ignored
    [Ultrasonic.h]
2020-03-19 Deception
    array_calc_focus is too slow :c
    [UltrasonicDump.csv]
2020-03-22 Timer and serial input
    [Ultrasonic Dump JSON.txt]
2020-03-25 Pattern to Port
    VERY low performance. Will need to calculate the port registers for each "step" of the wave before outputing the signal
    [UltrasonicDump.xlsx]
2020-03-31 Trajectory planning
    + code organized
    - unused stuff
    + many misnamed variables fixed
    [main.c]
2020-04-01 New timer
2020-04-16 Fix compilation problems
    no missing commas BUT extra commas :(
    [Debug.h, Timer5.c, main.c]
2020-05-13 new debug features
    [Mega Port Registers.xlsx]
2020-05-15 bug fixes
    [Mega Port Registers.xlsx]
2020-05-16 More bug fixes
    Looks like Timer 4 and Timer 5 doesn't like each other, as theys weren't working at the same time. Changing from timer 5 to timer 3 solved the problem
    [Timer3.c, Timer3.h, Timer4.c, Timer5.c, Timer5.h, main.c]
2020-05-20 New folders for hardware development
    [MEGA2560_Rev3e.brd, MEGA2560_Rev3e.sch, dimensioniMega.dxf]
2020-05-21 Created schematic
    [UltrasonicMatrix.brd, UltrasonicMatrix.sch]
2020-05-22 schematic done
    [PBCtest.brd, PBCtest.sch, UltrasonicMatrix.brd, UltrasonicMatrix.sch]
2020-05-24 more tracing
    [UltrasonicMatrix.brd, UltrasonicMatrix.sch]
2020-05-25 almost done
    [UltrasonicMatrix.brd, UltrasonicMatrix.sch]
2020-05-26 more on board layout
    [UltrasonicMatrix.brd, UltrasonicMatrix.sch]
2020-05-26 routing completed
    [UltrasonicMatrix.brd]
2020-05-27 Board completed
    [UltrasonicMatrix.brd, UltrasonicMatrix.sch]
2020-05-31 Board design enhancments
    * New alignment marks
    * Increased thermal isolation to 20mil
    * Upgraded PCBtest to new design rules with 20mil clearance and increased text size to test the same object sizes of the main board
    [PBCtest.brd, PBCtest.sch, UltrasonicMatrix.brd]
2020-06-03 Updated test board
2020-06-04 Speed fix
    Optimized the signal output code. Now it takes 49 processor cycles to update the output
    [Timer4.c, Ultrasonic.c, Ultrasonic.h, src.ino]
2020-06-05 Bit Banging
    * The Timer4 approach was replaced by a asm routine to archive a fast update rate.
    * The phase resolution was reduced to 8bits (wasn't able to reach 400kHz refresh rate).
    * Transducer spacing reduced to 1mm.
    * Fixed the duty cycle calculation in the pattern generation function.
    [Ultrasonic.c, Ultrasonic.h, src.ino]
2020-06-12 Board minor adjustments
    * Fixed some details in the board layout
    * Assigned the pin mapping in software
    [Pin Mapping and Calibration.xlsx, UltrasonicMatrix.brd]
2020-06-14 Loaded Phase Compensation
    [Pin Mapping and Calibration.xlsx]
2020-06-16 Phase accuracy increased
    * Increased phase accuracy in focus calculations (Ultrasonic.c).
    * When calculating the pattern, will round the phase delay based on the phase resolution (Ultrasonic.c).
    * Solved the problem caused by the Timer0 interrupts. Now the Timer0 will be disabled until there is input data, when it will be enabled then disabled before activating the transducers.
    * Solved a problem in the calculation for the timer interval of the trajectory, which was caused if the speed was negative.
    * Fixed the pattern debug output, the pattern were being printed horizontally mirrored.
    * Created a layer for a millimeter grid in the board schematic.
    [UltrasonicMatrix.brd]
2020-06-17 Fixed phase focusing bug
    * The software was calculating whats the phase that the wave would arrive at focal point and assuming this phase as phase delay. But it needed to complement that calculated phase to assume as phase delay.
    [Ultrasonic.c]
2020-06-22 New grid ruller
    new grid ruller with 0.5mm resolution
    [UltrasonicMatrix.brd]
2021-04-27 Organized files
    - Organized file structure
    - Unused files deleted
    - Updated project readme and added project cover
    - Created readme files
    - Added bill of materials
    [Arduino Mega Port Registers.xlsx, MEGA2560_Rev3e.brd, MEGA2560_Rev3e.sch, Mega Port Registers.xlsx, PBCtest.brd, PBCtest.sch, dimensioniMega.dxf]
